RobinDavidss0n/scooter-gose-vrooom/esp32/diagrams/pin-definition.png

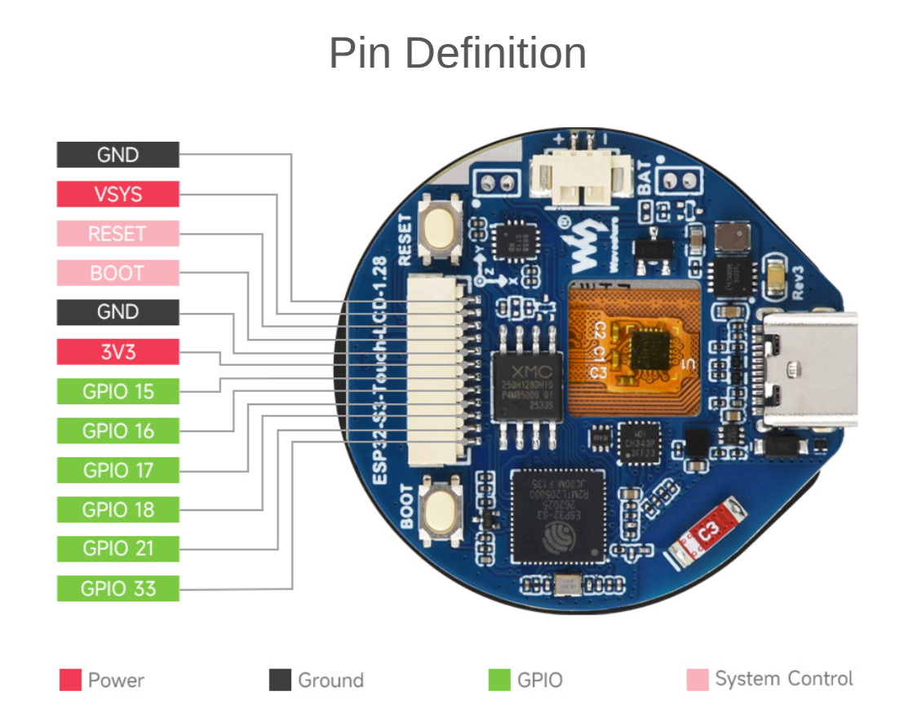
esp32/diagrams/pin-definition.png
