RobinDavidss0n/scooter-gose-vrooom/README.md

# Scooter Gose Vrooom 🛴⚡🪿

Custom controller swap for the **Xiaomi Elite NE** — replacing the stock MCU + ESC with a full open-source VESC-based stack.

## Hardware

| Component | Part |
|---|---|
| ESC | Makerbase VESC MINI 6.7 (VESC 6.6-based, 13S) |
| DC-DC | XL7015 / LM2596 — 5V–80V → adjustable 5V–20V |
| Controller | Waveshare ESP32-S3 1.28″ Touchscreen (GC9A01, 240×240, CST816S touch) |
| Motor | Xiaomi Elite NE hub motor (3-phase BLDC + Hall sensors) |
| Battery | Stock Xiaomi Elite NE battery (36V / 10S) |

## Safety Warning

> This modification bypasses Xiaomi's original safety firmware. You are responsible for
> verifying all current limits, voltage limits, and thermal protection settings before riding.
> Always wear protective gear.
