RobinDavidss0n/scooter-gose-vrooom/esp32/diagrams/extender/61dUMpSJDrL._AC_SL1500_.jpg

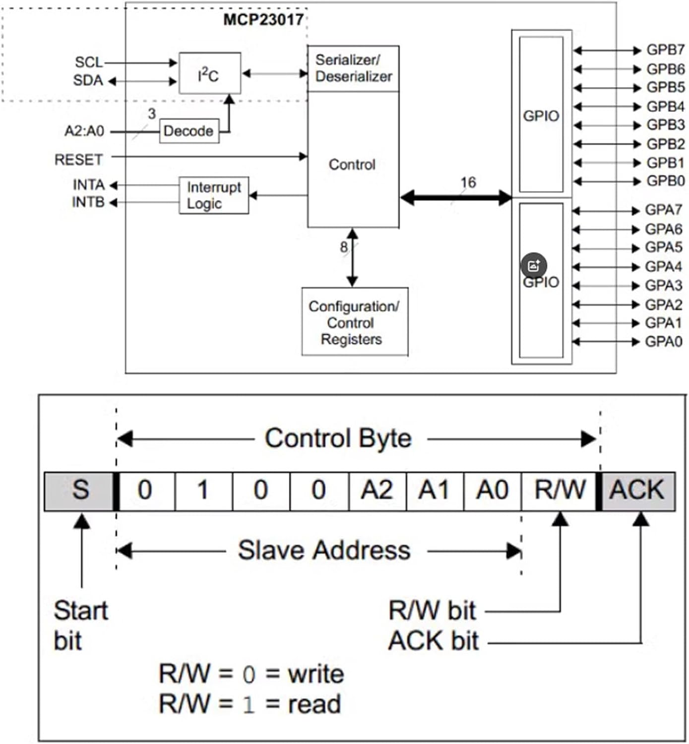
esp32/diagrams/extender/61dUMpSJDrL._AC_SL1500_.jpg
