RobinDavidss0n/scooter-gose-vrooom/esp32/diagrams/features .png

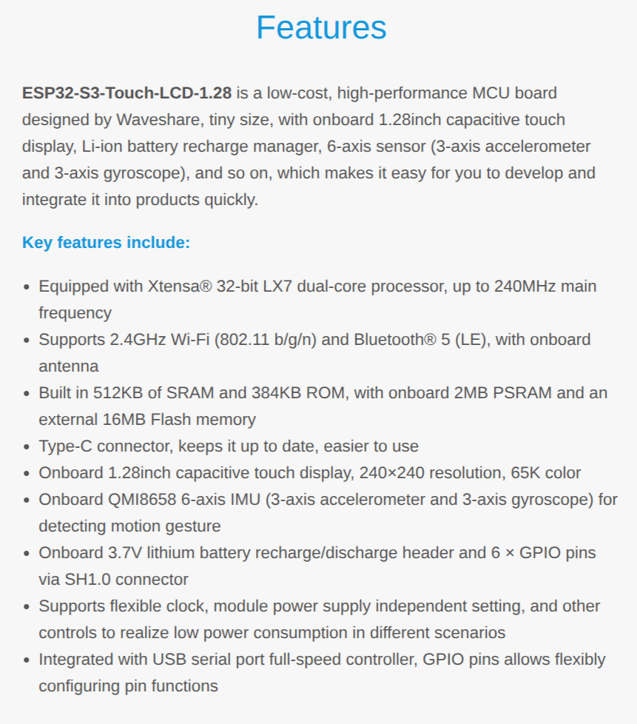
esp32/diagrams/features .png
