RobinDavidss0n/scooter-gose-vrooom/esp32/diagrams/outline-dimensions-back.png

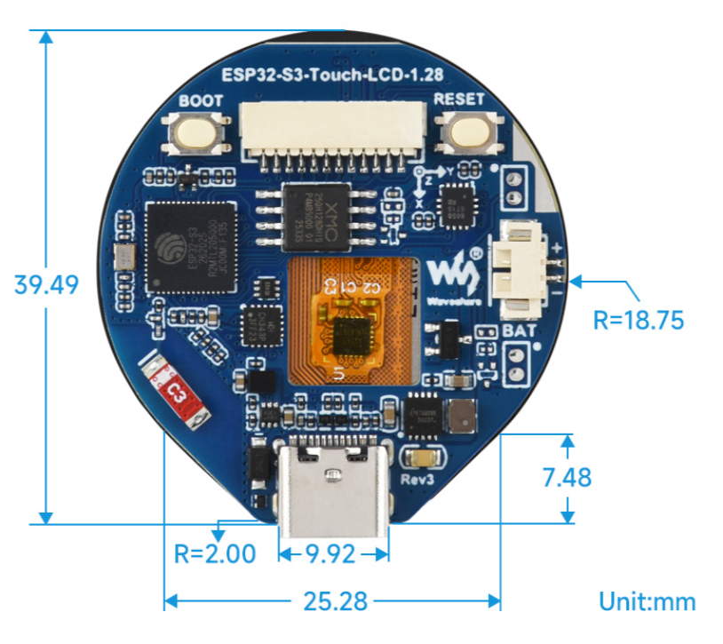
esp32/diagrams/outline-dimensions-back.png
