RobinDavidss0n/scooter-gose-vrooom/esp32/diagrams/outline-dimensions-front.png

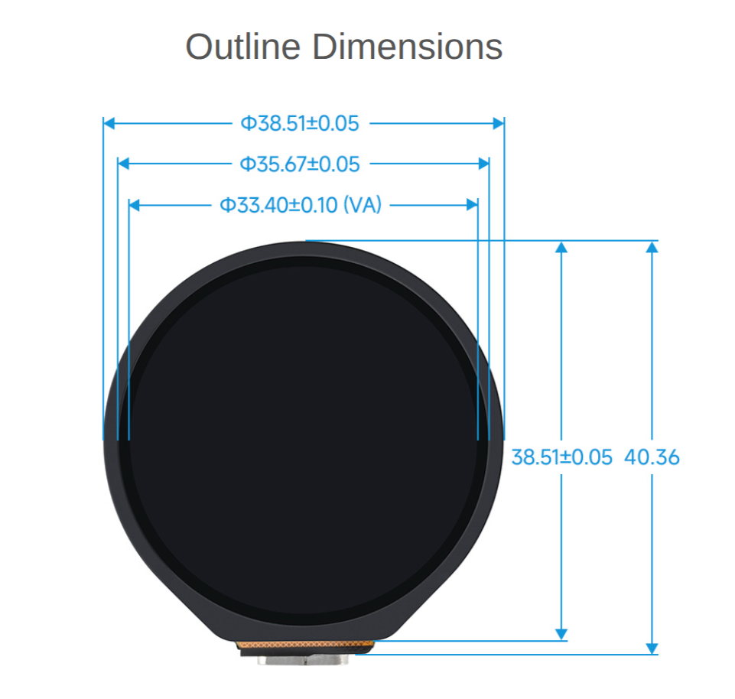
esp32/diagrams/outline-dimensions-front.png
