RobinDavidss0n/scooter-gose-vrooom/esp32/diagrams/whats-on-board.png

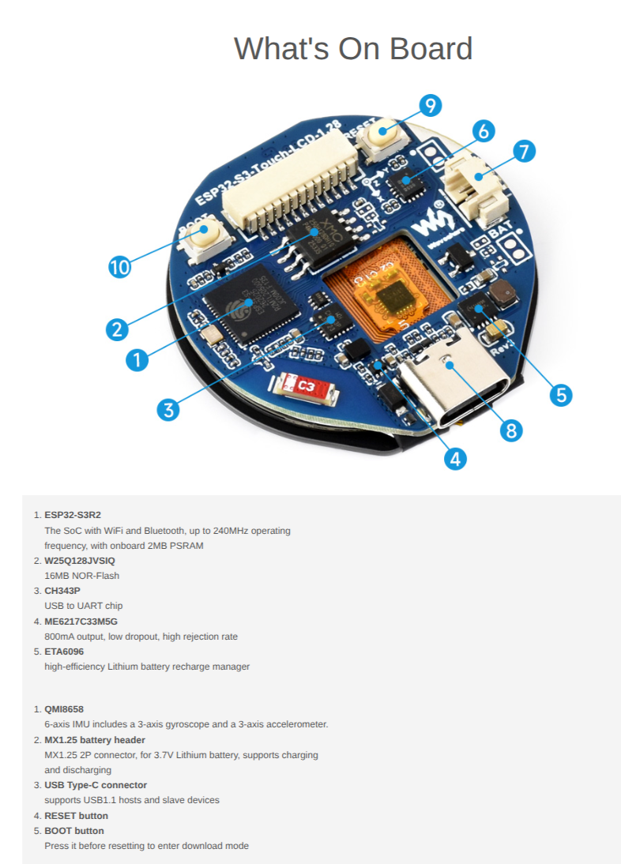
esp32/diagrams/whats-on-board.png
