RobinDavidss0n/scooter-gose-vrooom/vesc/setup.md

# VESC Setup

❕Note: These settings are only to be used for an **Xiaomi Elite**.
Any settings not mentioned in this guide should be left at their default value as they are set by the VESC setup wizard.

Setup the ESC using the [VESC tool](https://vesc-project.com/vesc_tool).

## Auto Wizard Setup (Setup Motors FOC)

1. Chose Generic
2. Chose DD hub motor
3. Battery:
   - *Type:* **Li-ion**
   - *Cells:* **10**
   - *Capacity:* **10 Ah** <br>
  Advanced:
      - *Regen:* **-8 A** (0.8 C)
      - *Current max:*<br>
				**20 A** (safe value, roughly 720 W at 36V)<br>
				**25 A** (overdrive value, roughly 900 W at 36V, **probably needs BMS bypass as OG BMS probably somewhere over 20 A**)<br>
				The battery theoretical max is around 30 A but introduces extreme degradation.
1. Setup:
   - *Direct drive:* **checked**
   - *Wheel diameter:* **254 mm (10 inch)**
   - *Motor poles:* **30**
   - *Temperature sensor:* **NTC 10k at 25C**
   - *Beta value for motor thermistor:* **3380K**

## Set/verify settings after the wizard

### Motor settings -> General

##### Current
- *Motor current max:* **37.5 A** <br>
Speed is proportional to voltage, so at lower speed the motor needs more current to keep the same wattage, over 40 A would probably damage the motor long term and mostly generates more heat.
- *Motor current max brake:* **-35 A**
- *Absolute maximum current:* **50 A** (For sudden spikes, if current goes over this threshold the VESC triggers an immediate emergency shutdown)
- *Battery current max:*<br>
	**20 A** (safe value, roughly 720 W at 36V)<br>
	**25 A** (overdrive value, roughly 900 W at 36V, **requires BMS bypass as OG limits to ~21 A**)<br>
	The battery theoretical max is around 30 A but introduces extreme degradation.
- *Battery current max regen:* **-8 A** (0.8 C)

#### Voltage
- *Battery voltage cutoff start:* **34.5 V** (when the battery voltage drops below this threshold, the VESC starts to limit the power to prevent over-discharging the battery)
- *Battery voltage cutoff end:* (when the battery voltage drops below this threshold, the VESC will completely cut off the power to protect the battery)<br>
	**33 V** (less battery degradation)<br>
	**30-31 V** (values under this will cause permanent damage)
- *Battery voltage regen cutoff start:* **40.5 V** (start to limit regen when the battery voltage start reaching this threshold)
- *Battery voltage regen cutoff end:* **41 V** (cut off regen when the battery voltage start reaching this threshold, prevents overcharging the battery)

#### Temperature
- *Motor temp cutoff start:* **70°C** (start limiting current when the motor temperature reaches this threshold)
- *Motor temp cutoff end:* **95°C** (completely cut off current when the motor temperature reaches this threshold)

#### BMS
- *BMS type:* **None** (VESC do not communicate with the BMS as its cant communicate with the OG BMS)

#### Advanced
- Maximum duty cycle: **95%** (gives the VESC some headroom voltage to use when at full power, as VESC use voltage over the current speed voltage as well for fine adjustments)
- Duty cycle current limit start: (softly ramp down current at the set duty cycle value, this is calculated as a percentage of the set *Maximum duty cycle*)<br>
   ⚠️ NOTE: When this is not at 100%, the motor might behave badly when *Field weakening* is used<br>
   **100%** = disabled, try this first and see if it rides smooth at top speed, if not try the next values<br>  
	**95%** = balanced, a bit less conservative (90.25% of 100% duty cycle)<br>
	**90%** = smoother and more conservative (85.5% of 100% duty cycle)<br>

## Enabling Field Weakening

Field weakening works by injecting a extra current in the d-axis to weaken the magnetic field of the motor, allowing it to spin faster than its natural speed. This current do not give any extra torque, it will only generate extra heat so it drastically reduce efficiency.
⚠️ NOTE: This setting might behave badly with *Duty cycle current limit start*<br>

**⚠️ DANGER ⚠️**

**Enabling field weakening poses several risks to both the motor and the rider:**
- *Rider safety:* If the VESC in someway stop working while the scooter is at high speed using the field weakening, the VESC will stop supplying current to keep the field weakening active and can cause strong drag, regen, or abrupt deceleration depending on the fault mode, as the field is no longer weakened. Or in worst case a short in the motor phases, that would causes an immediate wheel lockup. Having the motor in the back wheel neglect the risk of catastrophic falls somewhat. Using this setting on a front wheel would be extremely dangerous and is not recommended.
- *Motor Damage:* The extra heat may damage the motor, this should only be used with motors that have a temperature sensor so one can set a temperature limit to prevent overheating.

Enable these settings for field weakening to work properly:

### Motor settings -> FOC
#### Field weakening
- *Field weakening current max:*<br>
   **3-5 A** (recommended starting range for test runs)<br>
   **5-8 A** (aggressive range)<br>
   **10 A** (brief experimental only, watch motor temperature closely)
- *Field weakening duty start:* **85%** (when the field weakening starts to take effect)
- *Field weakening ramp time:* **500 ms** (ramp time for the field weakening to reach its maximum effect)

### Motor settings -> General

#### RPM 
- *ERPM limit start:* **95%** (when the motor reaches 95% of the max ERPM, the VESC starts to limit the power to prevent a hard cutoff of power at top speed)
- *Suggested profiles:*<br>
   **12 600 ERPM** = **40.2 km/h** hard cap, starts tapering at **38.2 km/h**<br>
   **13 200 ERPM** = **42.1 km/h** hard cap, starts tapering at **40.0 km/h**<br>
   **14 100 ERPM** = **45.0 km/h** test profile, starts tapering at **42.8 km/h**<br>
   **15 700 ERPM** = **50.1 km/h** experimental only, starts tapering at **47.6 km/h**
- *Low-voltage note:* At around **36 V**, reaching **40 km/h** already needs field weakening.
- *Power-loss risk with field weakening:* If the VESC loses power/control above base speed, the motor can feed back roughly its natural back-EMF into the ESC and potentially overvoltage/damage it.<br>
   **45 km/h** -> **~47 V**<br>
   **50 km/h** -> **~52 V**<br>
   **55 km/h** -> **~57.5 V** (little margin left on a **60 V** ESC)
