RobinDavidss0n/scooter-gose-vrooom/wiring/wiring-help-notes.txt

MCU									VESC
TX 18 (BLUE)  <---> RX POS 4 (GREEN)
RX 17 (GREEN) <---> TX POS 3 (BLUE)
