RobinDavidss0n/scooter-gose-vrooom/wiring/diagram.dist.png

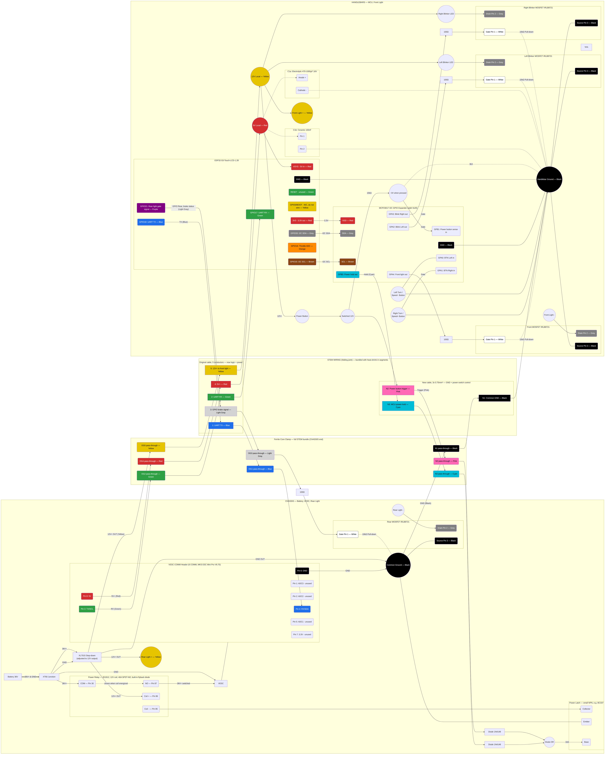
wiring/diagram.dist.png
