RobinDavidss0n/scooter-gose-vrooom/vesc/robin-elite-ne-result.png

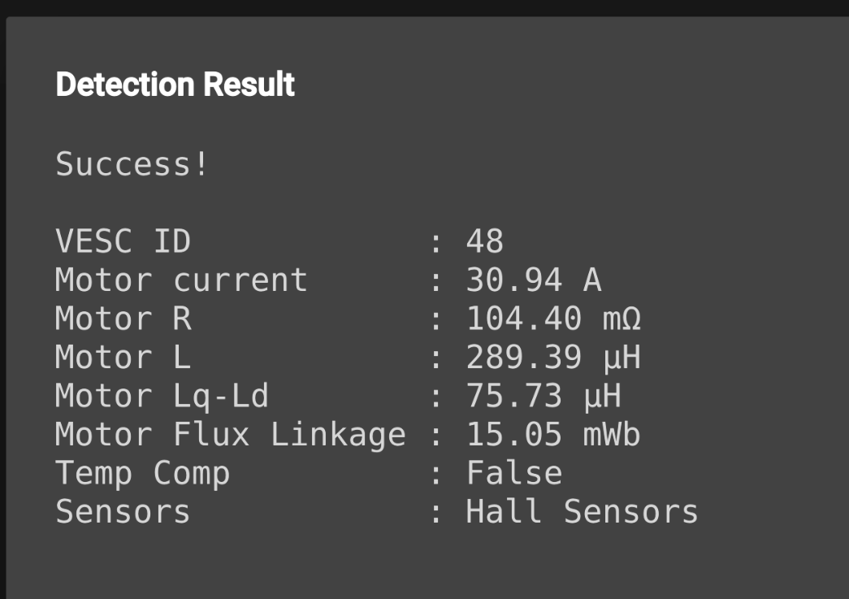
vesc/robin-elite-ne-result.png
