RobinDavidss0n/scooter-gose-vrooom/(commit log)

2026-05-23 Initial grönsaks commit
    [app_config.xml, motor_config_xiaomi_elite_ne.xml]
2026-05-29 Build errors for esp32 and re-structure folders
2026-05-31 Improved vesc folder
    [app_config.xml, motor_config_xiaomi_elite_ne.xml, vesc_appconf.xml, vesc_mcconf.xml]
2026-05-31 Made a VESC setup guide
    [app_config.xml, motor_config_xiaomi_elite_ne.xml, vesc_appconf.xml, vesc_mcconf.xml]
2026-05-31 Created VESC setup guide
2026-05-31 Updated VESC setup guide
2026-05-31 VESC settings improvements
2026-05-31 Initial ESP32 setup with simple text output
2026-06-01 added vesc wiring diagram
2026-06-08 E2E throttle works!
2026-06-14 Updated VESC setup
2026-08-09 Updated wiring diagrams and made lights code
